HawaiianMuonBeamline/HMB_CAD/README.md

# CAD
CAD model designs including structure and components for mechanical and simulations purposes
