HawaiianMuonBeamline/HMB_CAD/HMB_V3.1000/Board_supports/mounts_in_the_box.png

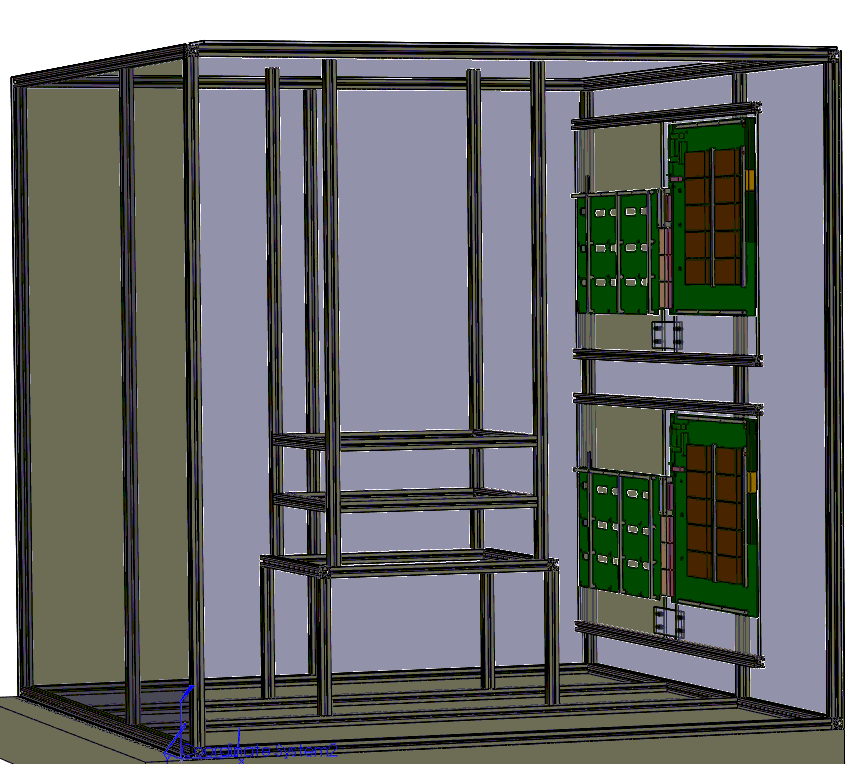
HMB_V3.1000/Board_supports/mounts_in_the_box.png
