HawaiianMuonBeamline/HMB_CAD/HMB_V3.1000/simplifiedDesigns/6CalAssembly.STL

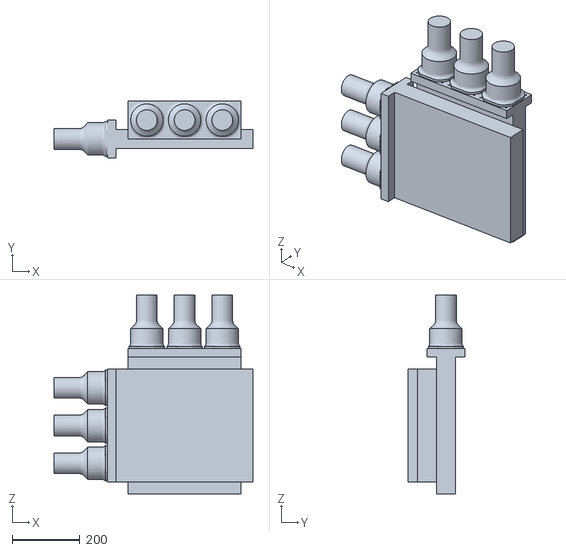
[picture p2: CAD file, 2021-06-29]
HMB_V3.1000/simplifiedDesigns/6CalAssembly.STL
586.0 x 166.7 x 586.0
