HawaiianMuonBeamline/HMB_CAD/HMB_V3.1000/Test_import_SW_Geant4/ASSIMP_pack_test/SciFi_MPPC_RevA_IDL_13_012_and_fibers.STEP

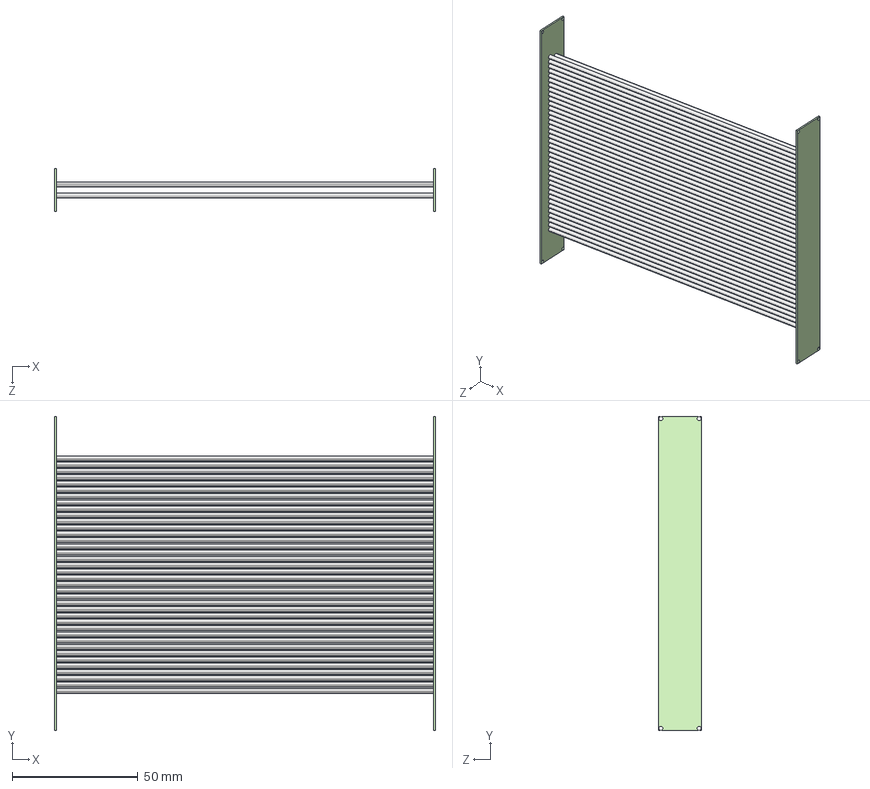
[picture p4: CAD file, 2020-10-21]
HMB_V3.1000/Test_import_SW_Geant4/ASSIMP_pack_test/SciFi_MPPC_RevA_IDL_13_012_and_fibers.STEP
151.6 x 125.0 x 17.0 mm
fiber x 75
fiber_guide_from_model x 2
