HawaiianMuonBeamline/HMB_CAD/HMB_V3.1000/Test_import_SW_Geant4/calorimeter/calorimeter.STL

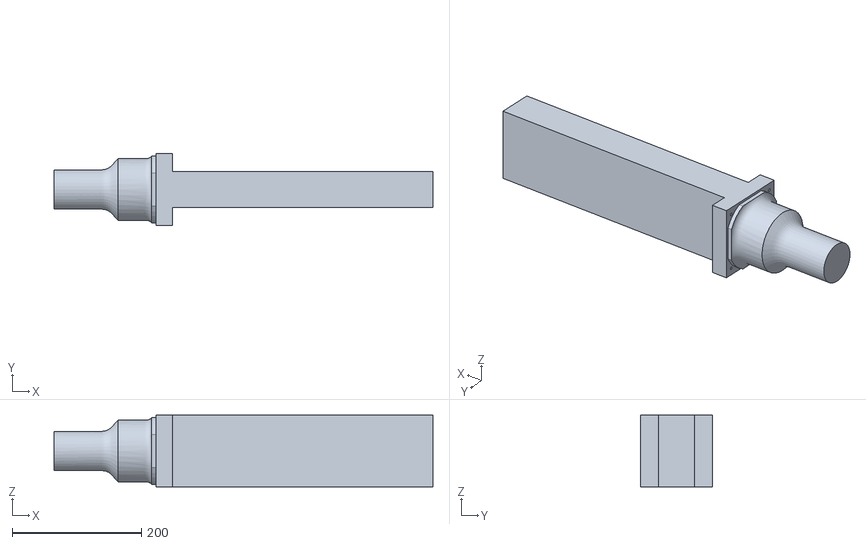
[picture p5: CAD file, 2021-04-19]
HMB_V3.1000/Test_import_SW_Geant4/calorimeter/calorimeter.STL
586.0 x 111.1 x 111.1
