HawaiianMuonBeamline/HMB_CAD/HMB_V3.1000/Test_import_SW_Geant4/SciFi_MPPC_RevA_IDL_11_023_and_fibers.STEP

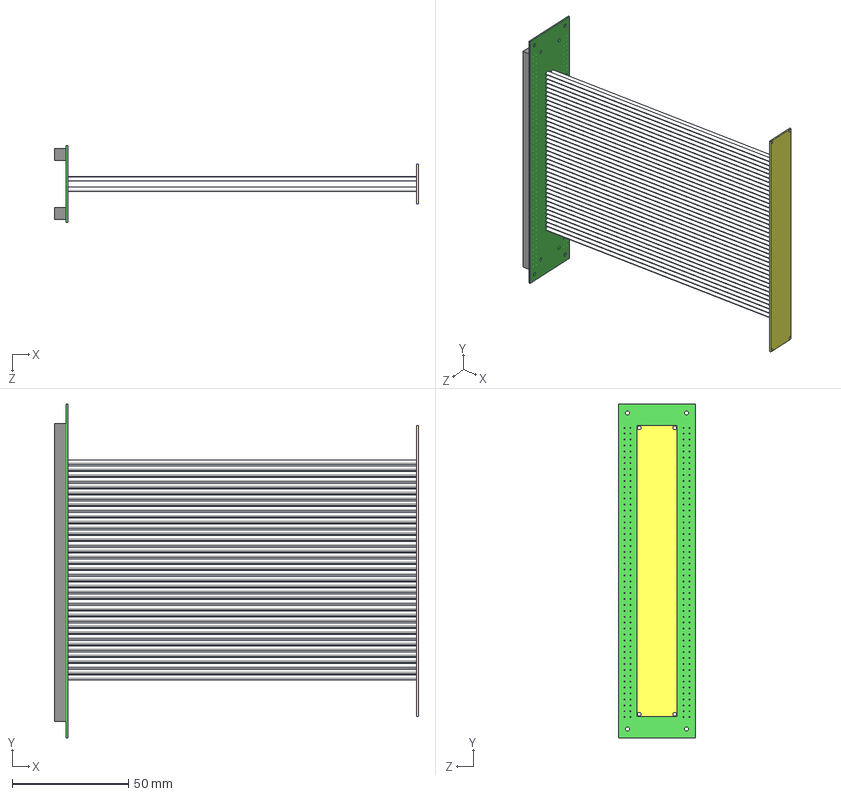
[picture p6: CAD file, 2020-09-14]
HMB_V3.1000/Test_import_SW_Geant4/SciFi_MPPC_RevA_IDL_11_023_and_fibers.STEP
156.6 x 143.5 x 33.0 mm
SciFi_MPPC_RevA_IDL_11_023
fiber x 75
fiber_guide_from_model
