HawaiianMuonBeamline/HMB_CAD/(list of files, cad)

Other CAD files:
HMB_V3.1000/Test_import_SW_Geant4/ASSIMP_pack_test/SciFi_MPPC_RevA_IDL_13_012_and_fibers.STL
