HawaiianMuonBeamline/HMB_CAD/HMB_V3.1000/Test_import_SW_Geant4/SciFi_MPPC_RevA_IDL_11_023_and_fibers.PDF

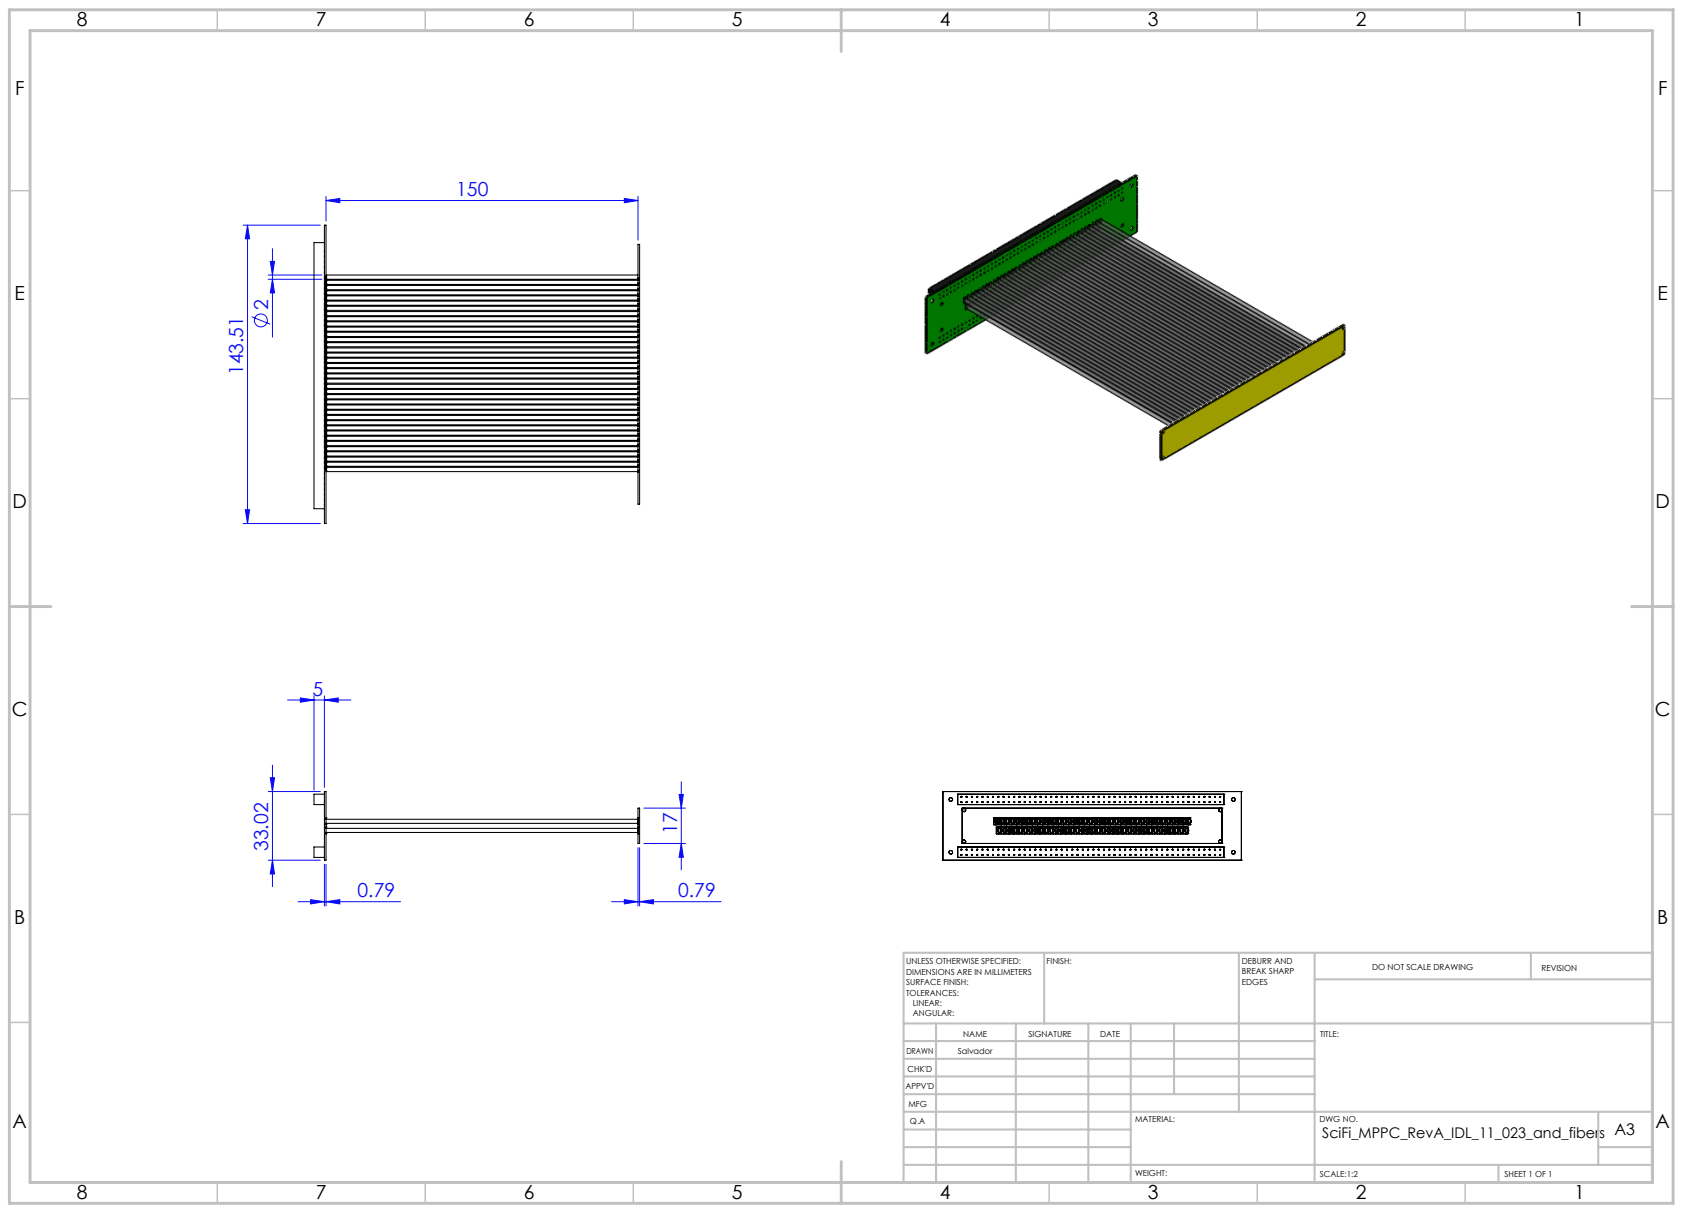
[picture p7: page 1]
FINISH:; DEBURR AND; BREAK SHARP; DO NOT SCALE DRAWING; REVISION; SCALE:1:2; SHEET 1 OF 1

UNLESS OTHERWISE SPECIFIED:
DIMENSIONS ARE IN MILLIMETERS
SURFACE FINISH:
TOLERANCES:
LINEAR:
ANGULAR:

NAME | SIGNATURE | DATE | | | | TITLE:

DRAWN | Salvador
CHK'D
APPV'D
MFG
Q.A | | | | MATERIAL: | DWG NO. SciFi_MPPC_RevA_IDL_11_023_and_fibers | A3
