HawaiianMuonBeamline/HMB_CAD/HMB_V3.1000/SciFiBoardSupport/scifiAcrylicSupport.pdf

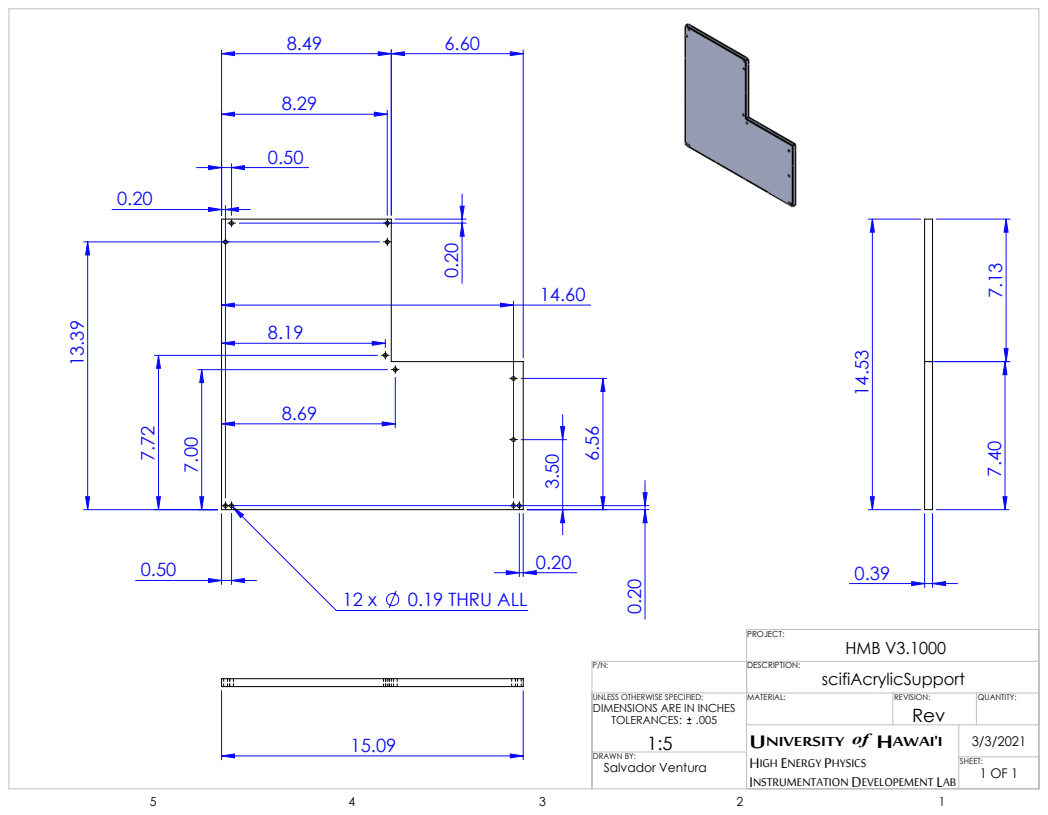
[picture p9: page 1]
0.19 THRU ALL; Salvador Ventura; HMB V3.1000; DRAWN BY:

P/N: | DESCRIPTION: scifiAcrylicSupport

UNLESS OTHERWISE SPECIFIED: DIMENSIONS ARE IN INCHES TOLERANCES: .005 1:5 | MATERIAL: | REVISION: Rev | QUANTITY:

UNIVERSITY of HAWAI'I H INSTRUMENTATION DEVELOPEMENT LAB | 3/3/2021 SHEET: IGH ENERGY PHYSICS
