HawaiianMuonBeamline/HMB_CAD/HMB_V3.1000/feedthroughbox/feedthroughBox_v2.pdf

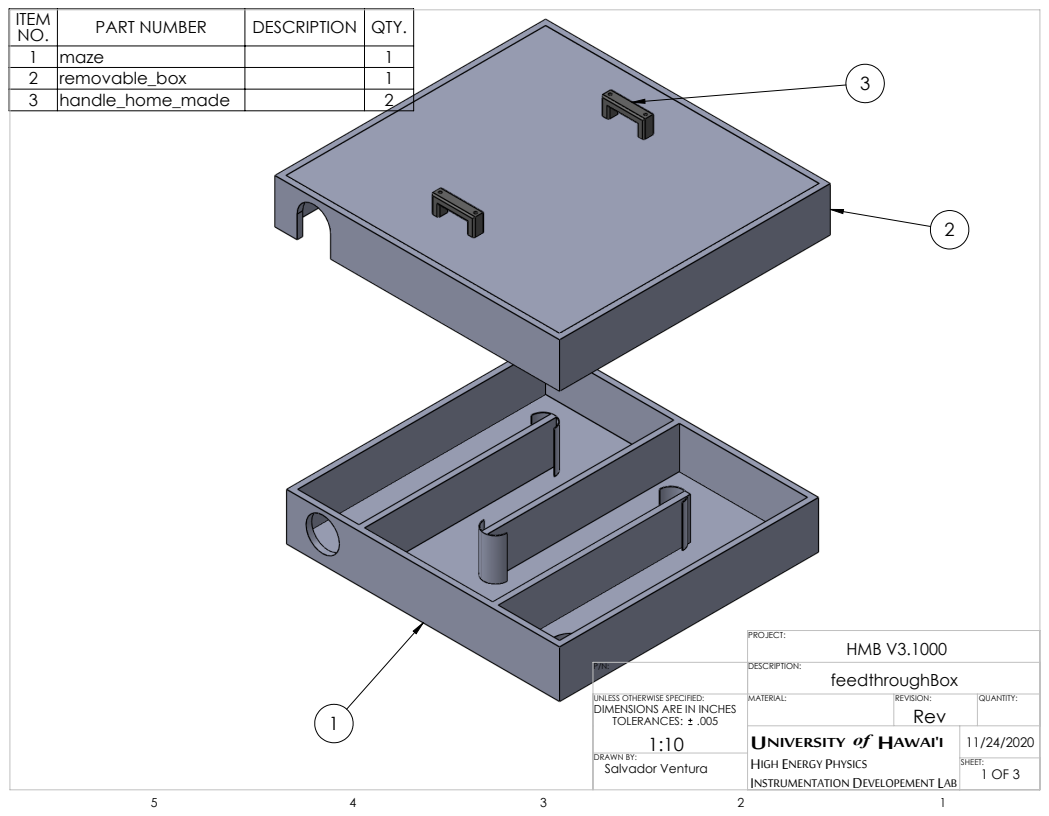
[picture p10: page 1]
Salvador Ventura; HMB V3.1000; DRAWN BY:

ITEM NO. | PART NUMBER | DESCRIPTION | QTY.
1 | maze | | 1
2 | removable_box | | 1
3 | handle_home_made | | 2

P/N: | DESCRIPTION: feedthroughBox

UNLESS OTHERWISE SPECIFIED: DIMENSIONS ARE IN INCHES TOLERANCES: .005 1:10 | MATERIAL: | REVISION: Rev | QUANTITY:

UNIVERSITY of HAWAI'I H INSTRUMENTATION DEVELOPEMENT LAB | 11/24/2020 SHEET: IGH ENERGY PHYSICS

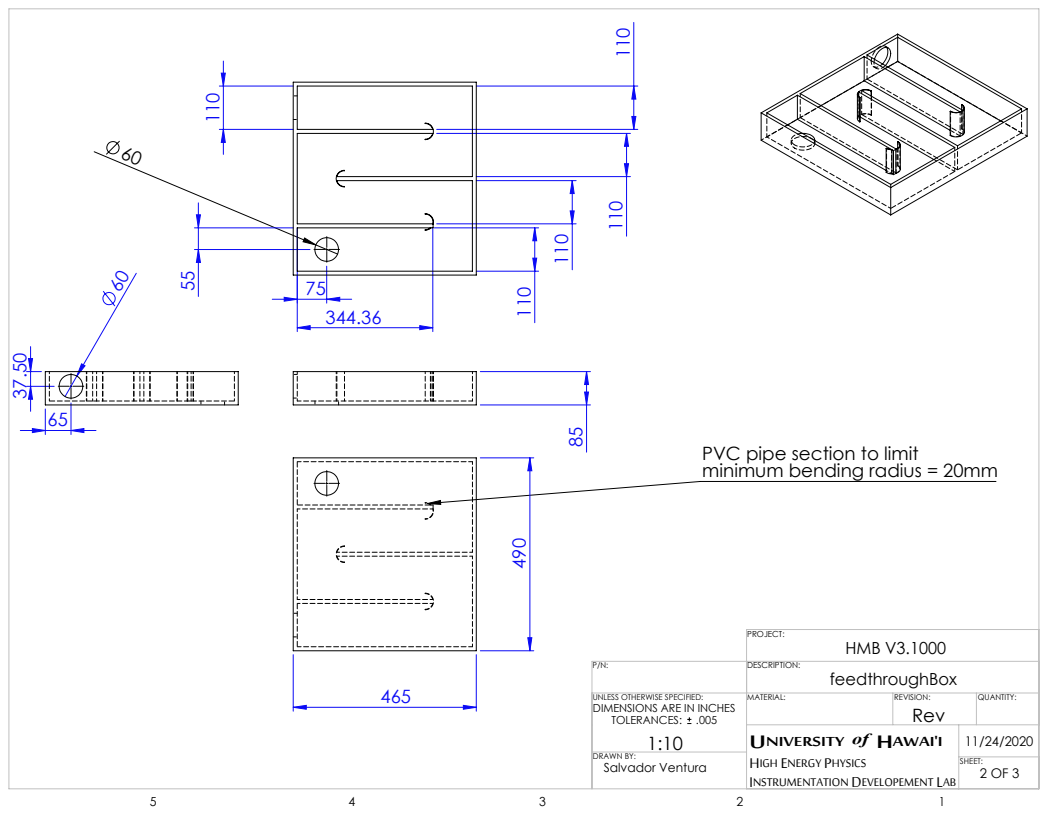
[picture p11: page 2]
HMB V3.1000; DRAWN BY:

PVC pipe section to limit
minimum bending radius = 20mm

P/N: | DESCRIPTION: feedthroughBox

UNLESS OTHERWISE SPECIFIED: DIMENSIONS ARE IN INCHES TOLERANCES: .005 1:10 | MATERIAL: | REVISION: Rev | QUANTITY:

UNIVERSITY of HAWAI'I | 11/24/2020

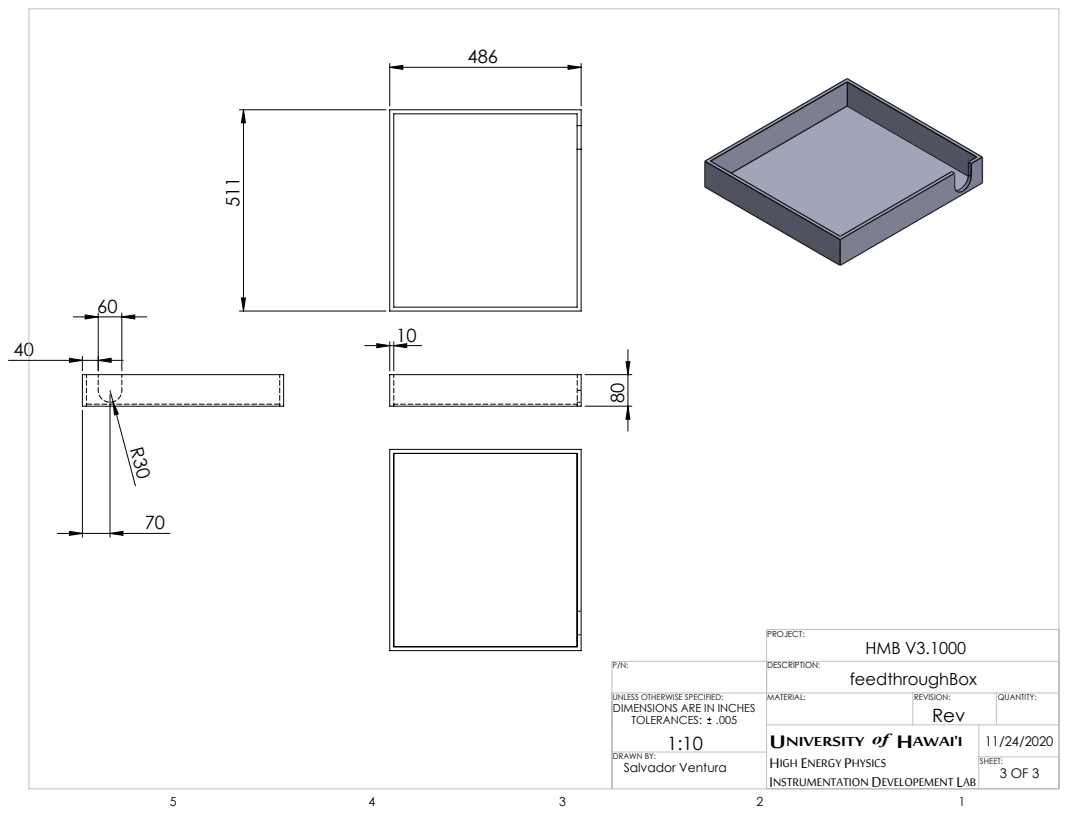
[picture p12: page 3]
HMB V3.1000; DRAWN BY:

P/N: | DESCRIPTION: feedthroughBox

UNLESS OTHERWISE SPECIFIED: DIMENSIONS ARE IN INCHES TOLERANCES: .005 1:10 | MATERIAL: | REVISION: Rev | QUANTITY:

UNIVERSITY of HAWAI'I | 11/24/2020
