HawaiianMuonBeamline/HMB_CAD/HMB_V3.1000/Board_supports/Acrylic_panes_for_support_v0.PDF

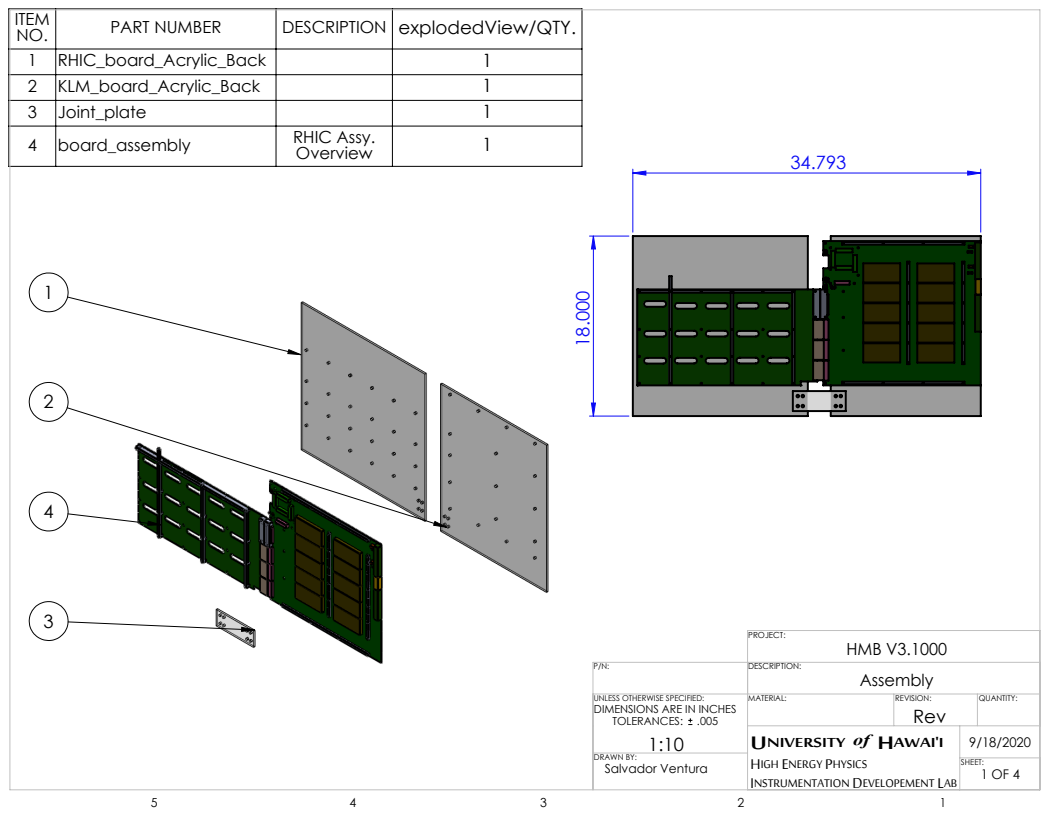
[picture p13: page 1]
Salvador Ventura; HMB V3.1000; DRAWN BY:

ITEM NO. | PART NUMBER | DESCRIPTION | explodedView/QTY.
1 | RHIC_board_Acrylic_Back | | 1
2 | KLM_board_Acrylic_Back | | 1
3 | Joint_plate | | 1
4 | board_assembly | RHIC Assy. Overview | 1

P/N: | DESCRIPTION: Assembly

UNLESS OTHERWISE SPECIFIED: DIMENSIONS ARE IN INCHES TOLERANCES: .005 1:10 | MATERIAL: | REVISION: Rev | QUANTITY:

UNIVERSITY of HAWAI'I H INSTRUMENTATION DEVELOPEMENT LAB | 9/18/2020 SHEET: IGH ENERGY PHYSICS

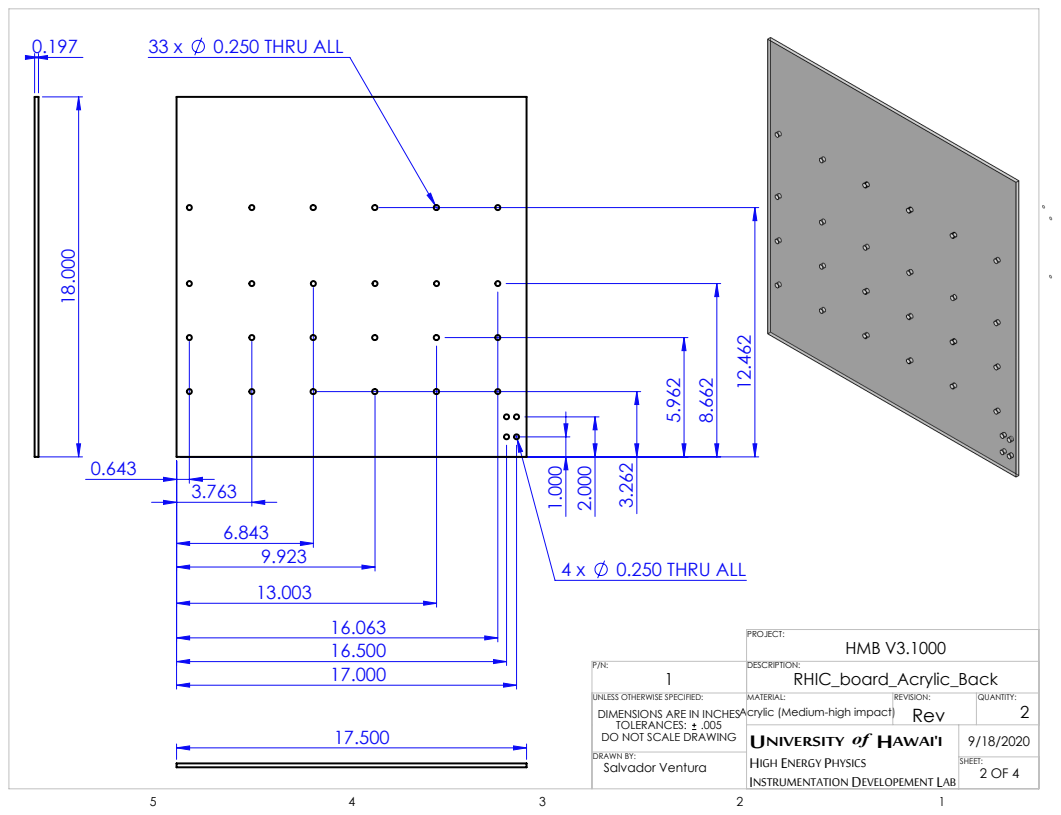
[picture p14: page 2]
0.250 THRU ALL; 0.250 THRU ALL 9.923; HMB V3.1000

P/N: 1 | DESCRIPTION: RHIC_board_Acrylic_Back

UNLESS OTHERWISE SPECIFIED: Acrylic (Medium-high impact) DIMENSIONS ARE IN INCHES TOLERANCES: .005 DO NOT SCALE DRAWING | MATERIAL: UNIVERSITY of HAWAI'I DRAWN BY: | REVISION: Rev | QUANTITY: 2

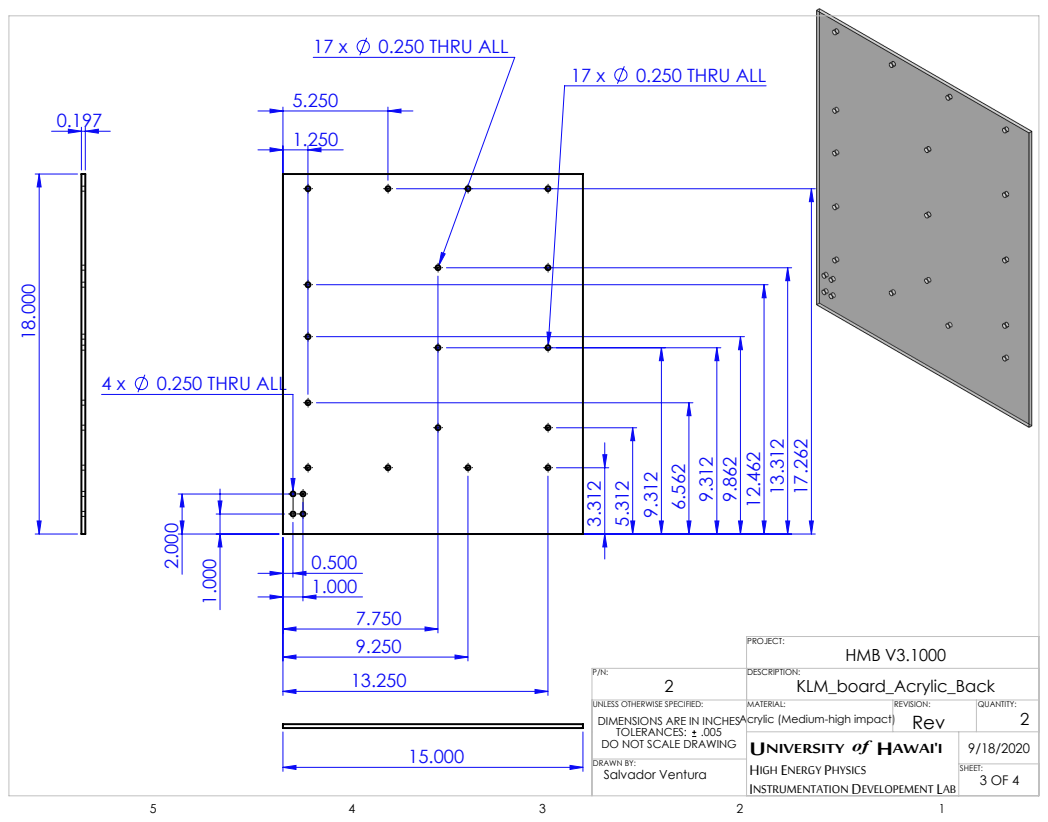
[picture p15: page 3]
0.250 THRU ALL; HMB V3.1000

P/N: 2 | DESCRIPTION: KLM_board_Acrylic_Back

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

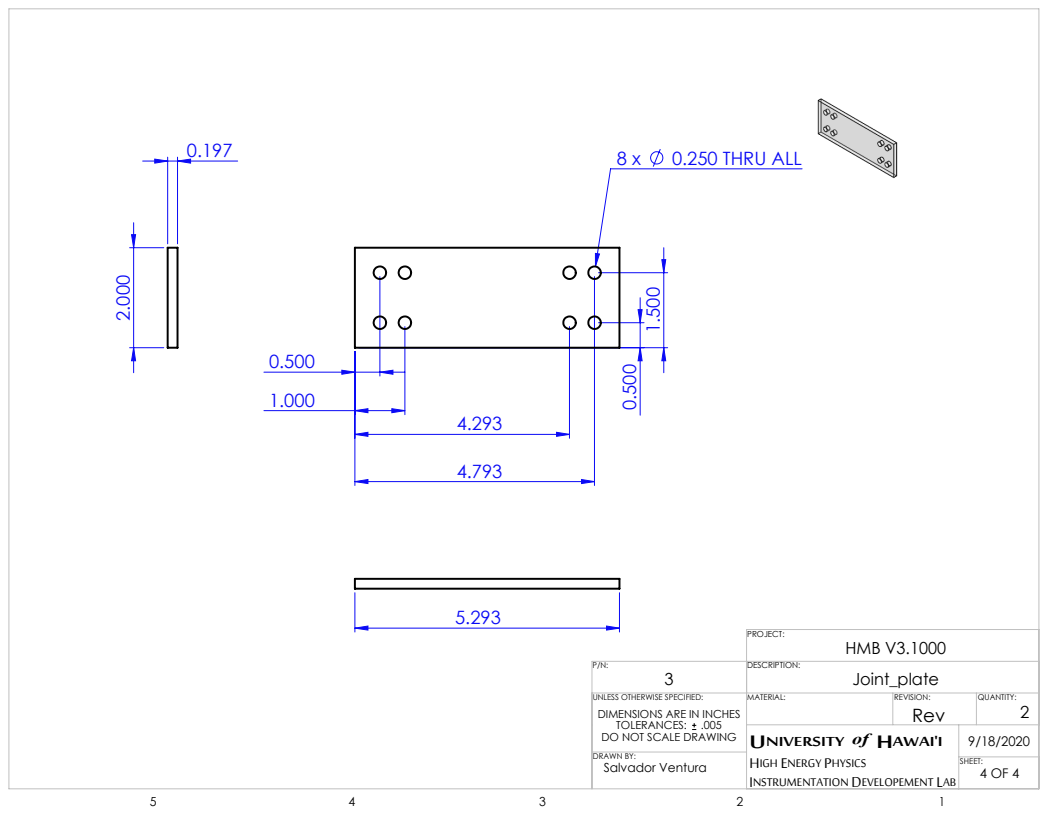
[picture p16: page 4]
0.250 THRU ALL; HMB V3.1000

P/N: 3 | DESCRIPTION: Joint_plate

UNLESS OTHERWISE SPECIFIED: DIMENSIONS ARE IN INCHES TOLERANCES: .005 DO NOT SCALE DRAWING | MATERIAL: UNIVERSITY of HAWAI'I DRAWN BY: | REVISION: Rev | QUANTITY: 2
