HawaiianMuonBeamline/HMB_CAD/(commit log)

2020-09-14 Preliminary design of a detector plane using the board. Components:
    - IDL ref number IDL_11_023 in https://bit.ly/2ZAz3c2
    - 2 mm diam, 150 mm fiber.
    [SciFi_MPPC_RevA_IDL_11_023_and_fibers.STEP]
2020-09-14 Rename directory
    [SciFi_MPPC_RevA_IDL_11_023_and_fibers.STEP]
2020-09-18 Drawings for acrylic mounts v0
    First drawings of the acrylic panes for fabrication.
2020-09-18 Screenshot of the acrylic panes for KLM/RHIC boards
2020-09-18 Drawings for acrylic mounts v0
2020-09-22 Assembly including box, boards support and central tower
    [HMBv31000_0.STEP]
2020-10-21 Several file types to test ASSIMP package in DD4hep
    [SciFi_MPPC_RevA_IDL_13_012_and_fibers.STEP, SciFi_MPPC_RevA_IDL_13_012_and_fibers.STL]
2020-11-24 Change in hole diameter and wood thickness
2021-03-03 Acrylic Sci-fi Board support design
2021-04-19 Add calorimeter first version
    [calorimeter.STL]
2021-06-29 Simplified STL version of assemblies
    [6CalAssembly.STL]
2021-06-29 Material defined
    One material for each part and NaI material not defined yet
2021-07-20 Corrected stl file for SciFi fiber
